meowthink/thermocouple/hardware/DAS.kicad_pcb

## KiCad design hardware/DAS.kicad_pcb (2016-05-21)

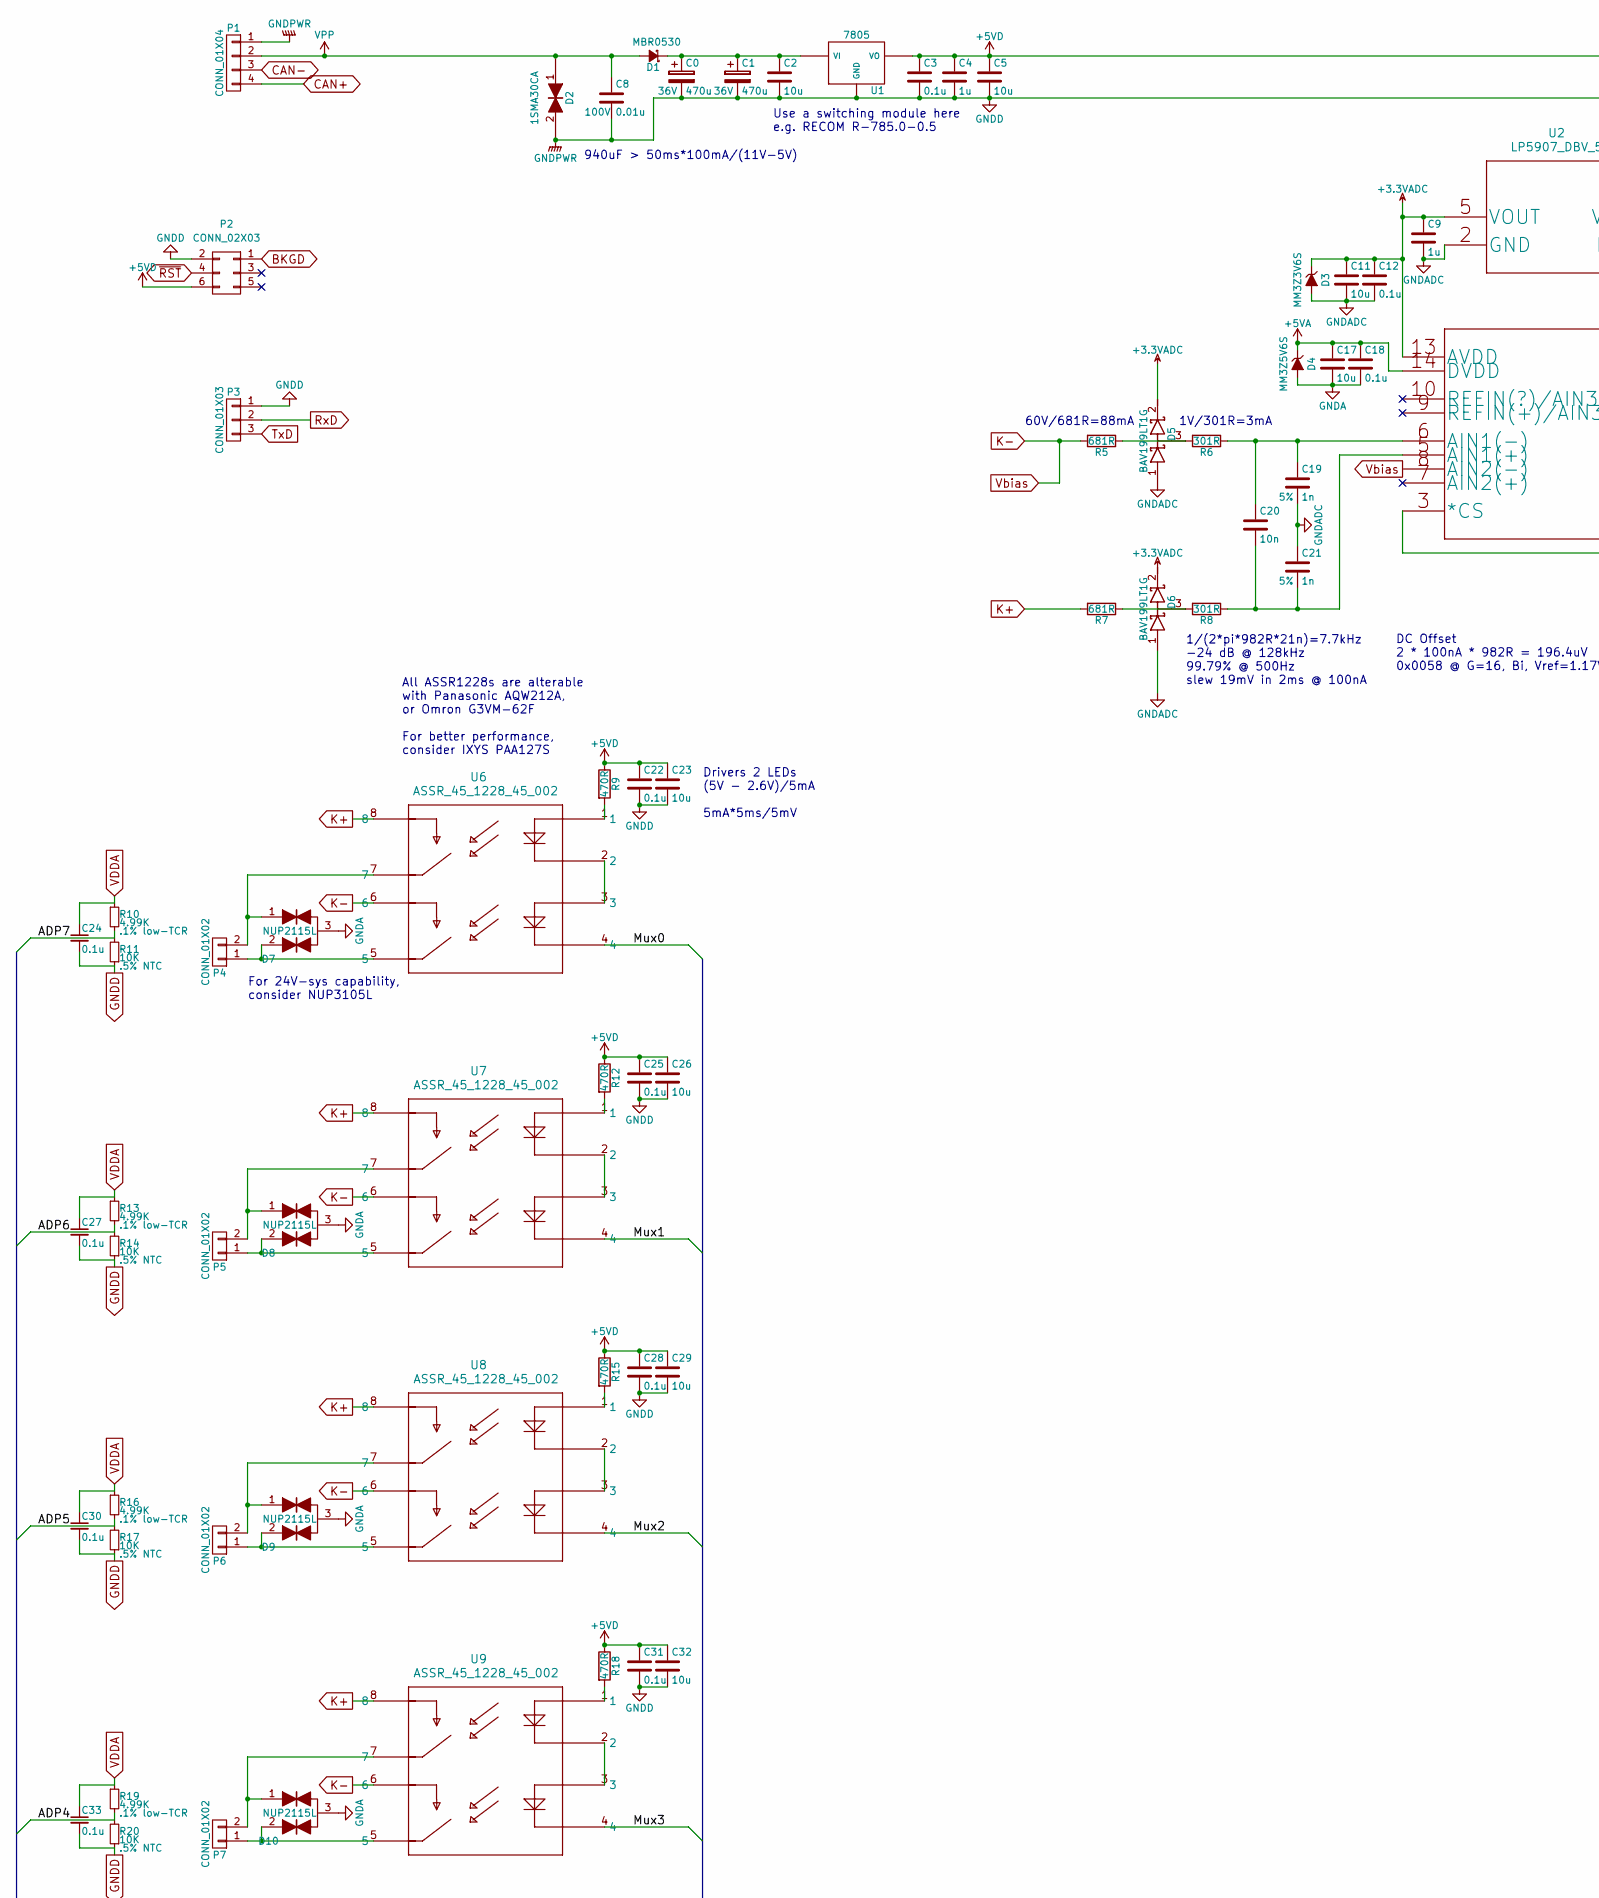
[picture p1: schematic DAS.sch, part in row 1, column 1]

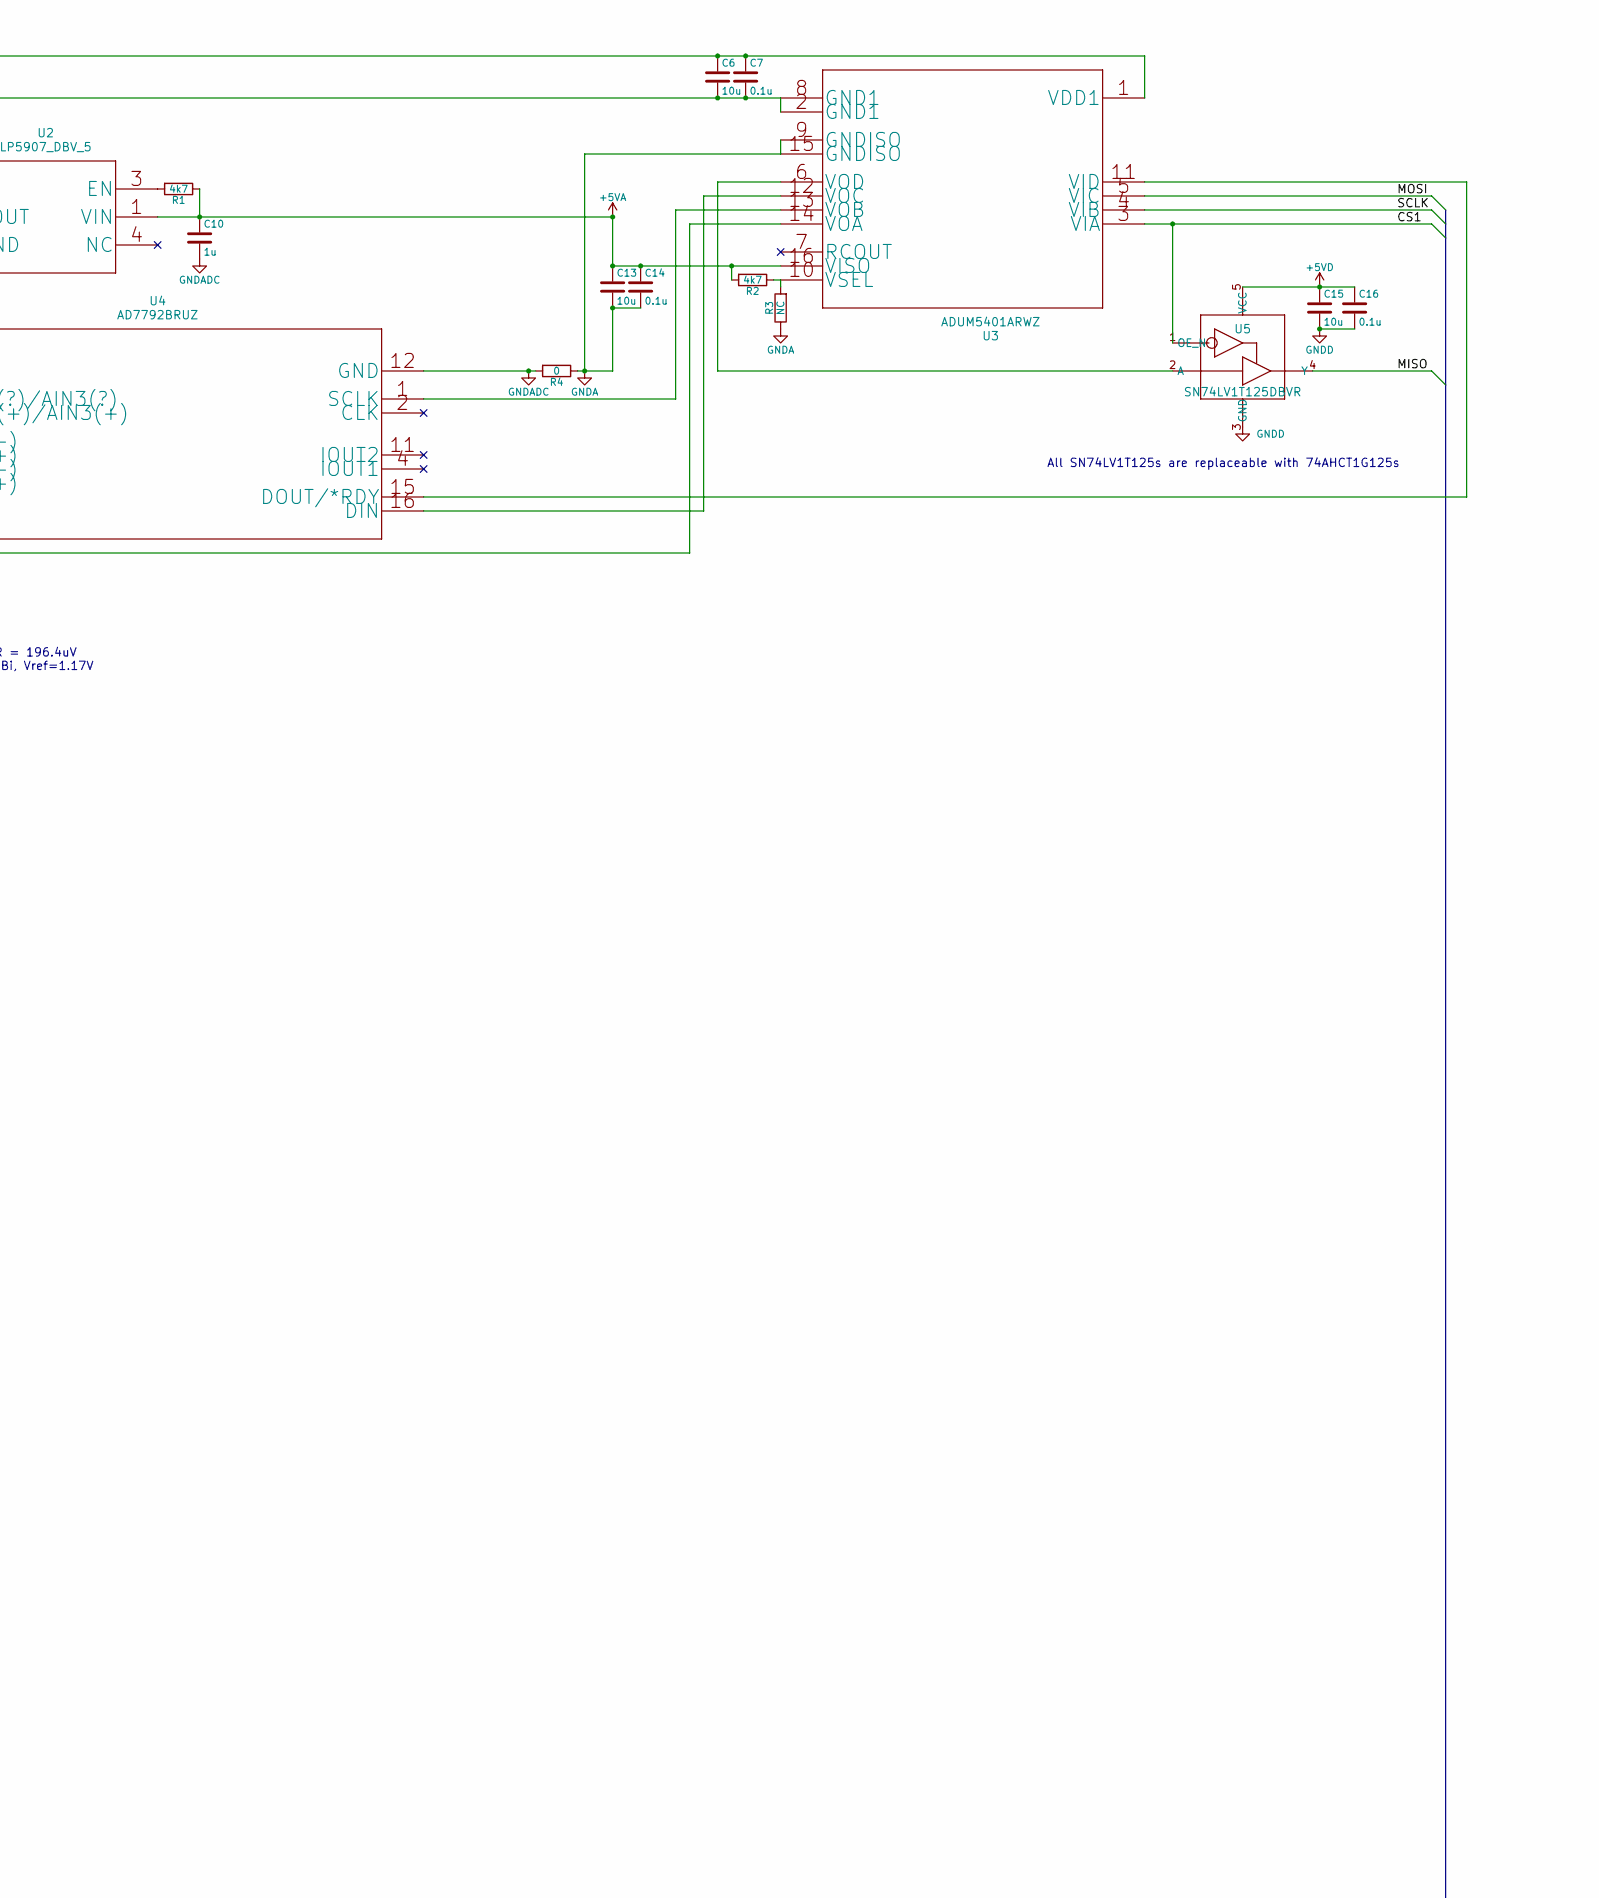
[picture p2: schematic DAS.sch, part in row 1, column 2]

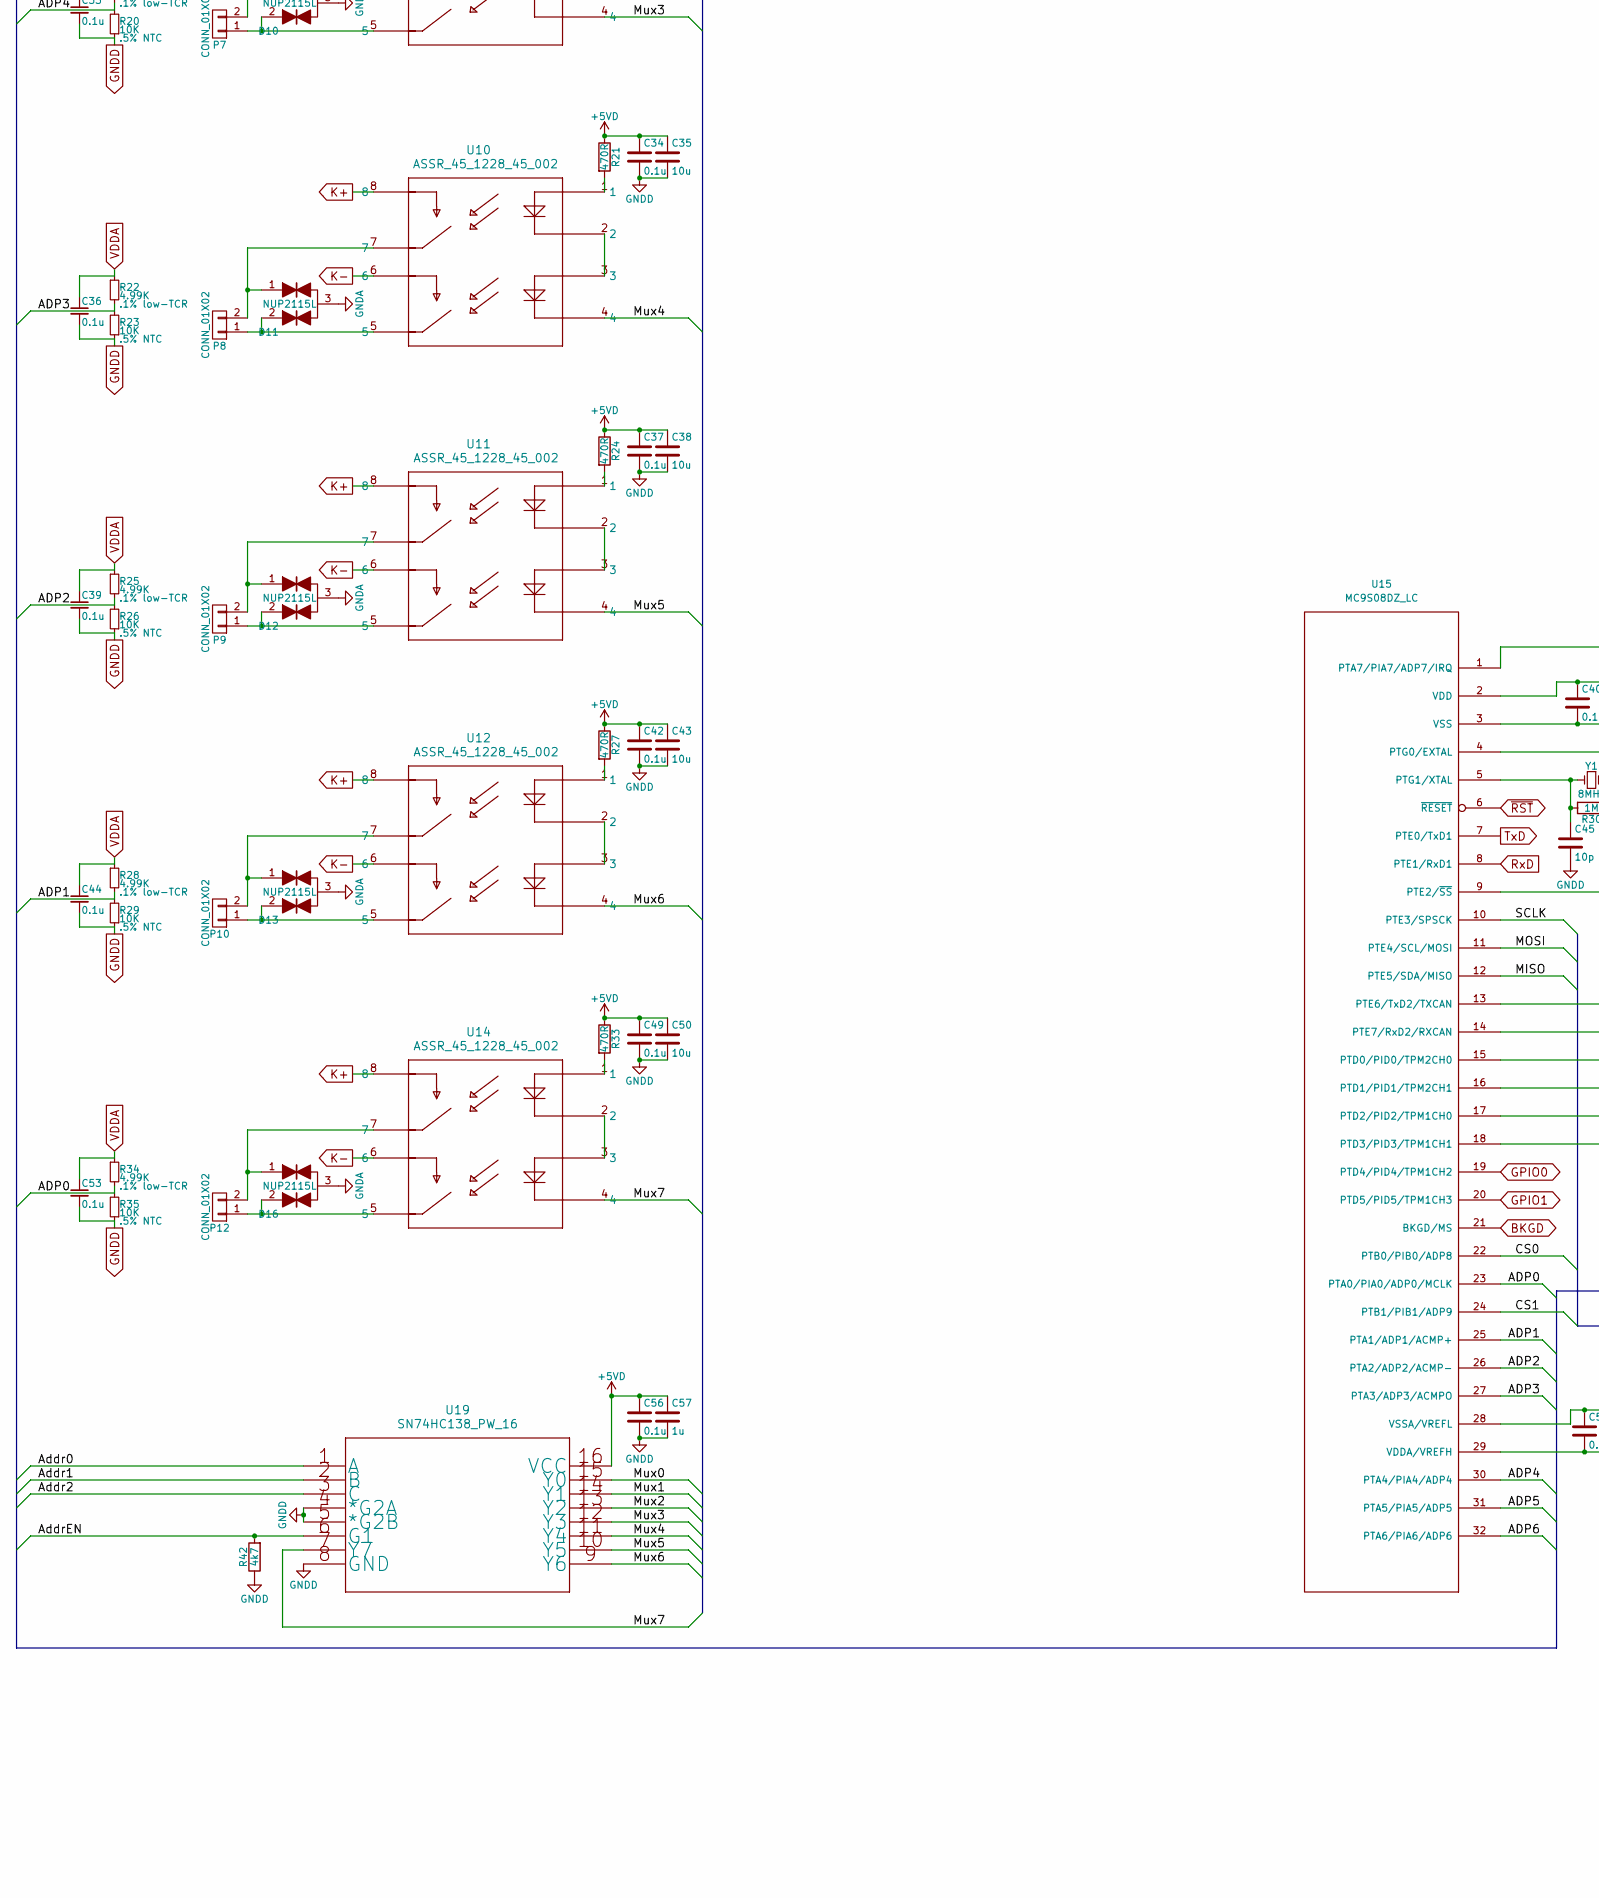
[picture p3: schematic DAS.sch, part in row 2, column 1]

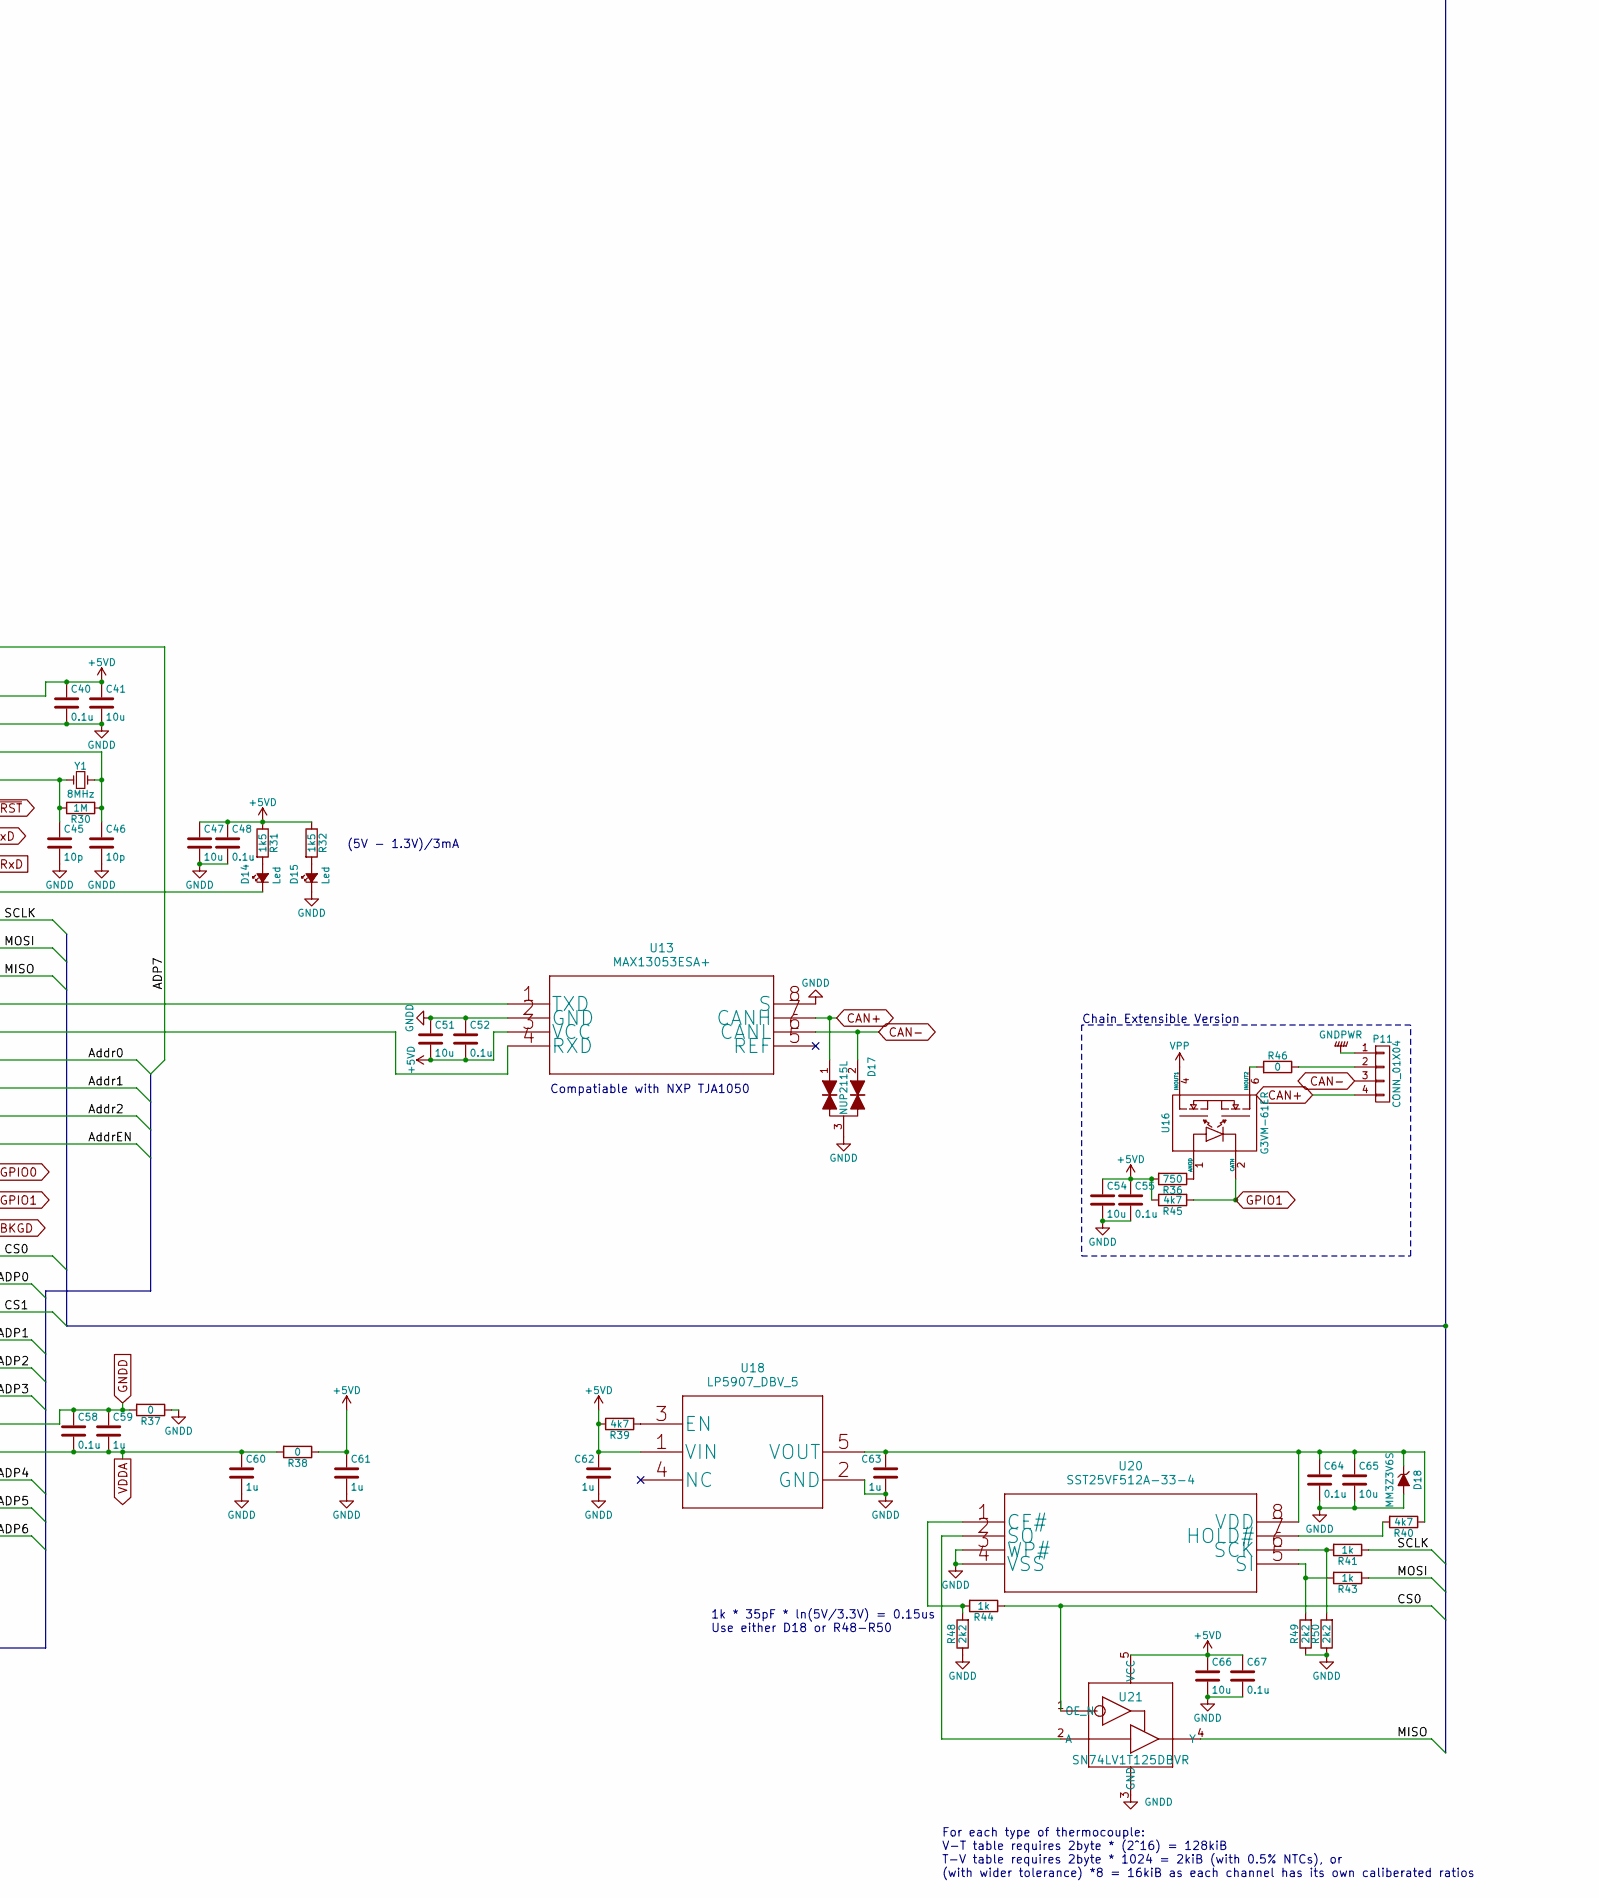
[picture p4: schematic DAS.sch, part in row 2, column 2]

Parts:
C0, C1: 470u; c_elec_10x10.5
C2, C5, C6, C11, C13, C15, C17, C23, C26, C29, C32, C35, C38, C41, C43, C47, C50, C51, C54, C65, C66: 10u; C_0805
C3, C7, C12, C14, C16, C18, C22, C24, C25, C27, C28, C30, C31, C33, C34, C36, C37, C39, C40, C42, C44, C48, C49, C52, C53, C55, C56, C58, C64, C67: 0.1u; C_0805
C4, C9, C10, C57, C59, C60, C61, C62, C63: 1u; C_0805
C8: 0.01u; C_0805
C19, C21: 1n; C_0805
C20: 10n; C_0805
C45, C46: 10p; C_0805
D1: MBR0530; SOD-123
D2: 1SMA30CA; SMA_Standard
D3, D18: MM3Z3V6S; SOD-323
D4: MM3Z5V6S; SOD-323
D5, D6: BAV199LT1G; SOT-23
D7, D8, D9, D10, D11, D12, D13, D16, D17: NUP2115L; SOT-23
D14, D15: Led; LED-5MM
P1, P11: CONN_01X04; Pin_Header_Straight_1x04
P2: CONN_02X03; Pin_Header_Straight_2x03
P3: CONN_01X03; Pin_Header_Straight_1x03
P4, P5, P6, P7, P8, P9, P10, P12: CONN_01X02; Thermocouple
R1, R2, R39, R40, R42, R45: 4k7; R_0805
R3: NC; R_0805
R4, R37, R38, R46: 0; R_0805
R5, R7: 681R; R_0805
R6, R8: 301R; R_0805
R9, R12, R15, R18, R21, R24, R27, R33: 470R; R_0805
R10, R13, R16, R19, R22, R25, R28, R34: 4.99K; R_0805
R11, R14, R17, R20, R23, R26, R29, R35: 10K; Thermoresistor
R30: 1M; R_0805
R31, R32: 1k5; R_0805
R36: 750; R_0805
R41, R43, R44: 1k; R_0805
R48, R49, R50: 2k2; R_0805
U1: 7805; DCDC-Conv_Recom_R-78HBxx-0.5
U2, U18: LP5907_DBV_5
U3: ADUM5401ARWZ; ADUM5401WCRWZ
U4: AD7792BRUZ
U5, U21: SN74LV1T125DBVR
U6, U7, U8, U9, U10, U11, U12, U14: ASSR_45_1228_45_002; SMD-8
U13: MAX13053ESA+
U15: MC9S08DZ_LC; LQFP-32_7x7mm_Pitch0.8mm
U16: G3VM-61ER; SMD-6
U19: SN74HC138_PW_16
U20: SST25VF512A-33-4
Y1: 8MHz; Crystal_HC49-SD_SMD

Connections:
+3.3VADC: C9.1, C11.1, C12.1, D3.1 (K), D5.2 (K), D6.2 (K), U2.5 (VOUT), U4.13 (AVDD)
+5VA: C10.1, C13.1, C14.1, C17.1, C18.1, D4.1 (K), R1.1, R2.2, U2.1 (VIN), U3.16 (VISO), U4.14 (DVDD)
+5VD: C3.1, C4.1, C5.1, C6.1, C7.1, C15.1, C16.1, C22.1, C23.1, C25.1, C26.1, C28.1, C29.1, C31.1, C32.1, C34.1, C35.1, C37.1, C38.1, C40.1, C41.1, C42.1, C43.1, C47.1, C48.1, C49.1, C50.1, C51.2, C52.2, C54.1, C55.1, C56.1, C57.1, C61.1, C62.1, C66.1, C67.1, P2.6, R9.1, R12.1, R15.1, R18.1, R21.1, R24.1, R27.1, R31.1, R32.1, R33.1, R36.2, R38.1, R39.1, R45.1, U1.1 (VO), U3.1 (VDD1), U5.5 (VCC), U13.3 (VCC), U15.2 (VDD), U18.1 (VIN), U19.16 (VCC), U21.5 (VCC)
/ADP0: R34.2, R35.2, U15.23 (PTA0/PIA0/ADP0/MCLK)
/ADP1: R28.2, R29.2, U15.25 (PTA1/ADP1/ACMP+)
/ADP2: R25.2, R26.2, U15.26 (PTA2/ADP2/ACMP-)
/ADP3: R22.2, R23.2, U15.27 (PTA3/ADP3/ACMPO)
/ADP4: R19.2, R20.2, U15.30 (PTA4/PIA4/ADP4)
/ADP5: R16.2, R17.2, U15.31 (PTA5/PIA5/ADP5)
/ADP6: R13.2, R14.2, U15.32 (PTA6/PIA6/ADP6)
/ADP7: R10.2, R11.2, U15.1 (PTA7/PIA7/ADP7/IRQ)
/Addr0: U15.15 (PTD0/PID0/TPM2CH0), U19.1 (A)
/Addr1: U15.16 (PTD1/PID1/TPM2CH1), U19.2 (B)
/Addr2: U15.17 (PTD2/PID2/TPM1CH0), U19.3 (C)
/AddrEN: R42.2, U15.18 (PTD3/PID3/TPM1CH1), U19.6 (G1)
/CS0: R44.1, U15.22 (PTB0/PIB0/ADP8), U21.1 (OE_N)
/CS1: U3.3 (VIA), U5.1 (OE_N), U15.24 (PTB1/PIB1/ADP9)
/MISO: U5.4 (Y), U15.12 (PTE5/SDA/MISO), U21.4 (Y)
/MOSI: R43.1, U3.5 (VIC), U15.11 (PTE4/SCL/MOSI)
/Mux0: U6.4, U19.15 (Y0)
/Mux1: U7.4, U19.14 (Y1)
/Mux2: U8.4, U19.13 (Y2)
/Mux3: U9.4, U19.12 (Y3)
/Mux4: U10.4, U19.11 (Y4)
/Mux5: U11.4, U19.10 (Y5)
/Mux6: U12.4, U19.9 (Y6)
/Mux7: U14.4, U19.7 (Y7)
/SCLK: R41.1, U3.4 (VIB), U15.10 (PTE3/SPSCK)
BKGD: P2.1, U15.21 (BKGD/MS)
CAN+: D17.1, P1.4, P11.4, U13.7 (CANH)
CAN-: D17.2, P1.3, P11.3, U13.6 (CANL)
GNDA: C13.2, C14.2, C17.2, C18.2, D4.2 (A), D7.3, D8.3, D9.3, D10.3, D11.3, D12.3, D13.3, D16.3, R3.1, R4.1, U3.9 (GNDISO), U3.15 (GNDISO)
GNDADC: C9.2, C10.2, C11.2, C12.2, C19.2, C21.1, D3.2 (A), D5.1 (A), D6.1 (A), R4.2, U2.2 (GND), U4.12 (GND)
GNDD: C0.2, C1.2, C2.2, C3.2, C4.2, C5.2, C6.2, C7.2, C8.2, C15.2, C16.2, C22.2, C23.2, C24.2, C25.2, C26.2, C27.2, C28.2, C29.2, C30.2, C31.2, C32.2, C33.2, C34.2, C35.2, C36.2, C37.2, C38.2, C39.2, C40.2, C41.2, C42.2, C43.2, C44.2, C45.2, C46.2, C47.2, C48.2, C49.2, C50.2, C51.1, C52.1, C53.2, C54.2, C55.2, C56.2, C57.2, C58.1, C59.1, C60.2, C61.2, C62.2, C63.2, C64.2, C65.2, C66.2, C67.2, D2.2, D15.1 (K), D17.3, D18.2 (A), P1.1, P2.2, P3.1, P11.1, R11.1, R14.1, R17.1, R20.1, R23.1, R26.1, R29.1, R35.1, R37.1, R37.2, R42.1, R48.1, R49.1, R50.1, U1.2 (GND), U3.2 (GND1), U3.8 (GND1), U5.3 (GND), U13.2 (GND), U13.8 (S), U15.3 (VSS), U15.28 (VSSA/VREFL), U18.2 (GND), U19.4 (*G2A), U19.5 (*G2B), U19.8 (GND), U20.3 (WP#), U20.4 (VSS), U21.3 (GND)
GPIO0: U15.19 (PTD4/PID4/TPM1CH2)
GPIO1: R45.2, U15.20 (PTD5/PID5/TPM1CH3), U16.2 (CATH)
K+: R7.2, U6.8, U7.8, U8.8, U9.8, U10.8, U11.8, U12.8, U14.8
K-: R5.2, U4.8 (AIN2(-)), U6.6, U7.6, U8.6, U9.6, U10.6, U11.6, U12.6, U14.6
unnamed: C0.1, C1.1, C2.1, D1.1 (K), U1.3 (VI)
unnamed: C19.1, C20.1, R6.1, U4.6 (AIN1(-))
unnamed: C20.2, C21.2, R8.1, U4.5 (AIN1(+))
unnamed: C45.1, R30.1, U15.5 (PTG1/XTAL), Y1.1
unnamed: C46.1, R30.2, U15.4 (PTG0/EXTAL), Y1.2
unnamed: C63.1, C64.1, C65.1, D18.1 (K), R40.1, U18.5 (VOUT), U20.8 (VDD)
unnamed: D5.3 (common), R5.1, R6.2
unnamed: D6.3 (common), R7.1, R8.2
unnamed: D7.1, P4.2, U6.7
unnamed: D7.2, P4.1, U6.5
unnamed: D8.1, P5.2, U7.7
unnamed: D8.2, P5.1, U7.5
unnamed: D9.1, P6.2, U8.7
unnamed: D9.2, P6.1, U8.5
unnamed: D10.1, P7.2, U9.7
unnamed: D10.2, P7.1, U9.5
unnamed: D11.1, P8.2, U10.7
unnamed: D11.2, P8.1, U10.5
unnamed: D12.1, P9.2, U11.7
unnamed: D12.2, P9.1, U11.5
unnamed: D13.1, P10.2, U12.7
unnamed: D13.2, P10.1, U12.5
unnamed: D14.1 (K), U15.9 (PTE2/~SS)
unnamed: D14.2 (A), R31.2
unnamed: D15.2 (A), R32.2
unnamed: D16.1, P12.2, U14.7
unnamed: D16.2, P12.1, U14.5
unnamed: P11.2, R46.1
unnamed: R1.2, U2.3 (EN)
unnamed: R2.1, R3.2, U3.10 (VSEL)
unnamed: R9.2, U6.1
unnamed: R12.2, U7.1
unnamed: R15.2, U8.1
unnamed: R18.2, U9.1
unnamed: R21.2, U10.1
unnamed: R24.2, U11.1
unnamed: R27.2, U12.1
unnamed: R33.2, U14.1
unnamed: R36.1, U16.1 (ANOD)
unnamed: R39.2, U18.3 (EN)
unnamed: R40.2, U20.7 (HOLD#)
unnamed: R41.2, R50.2, U20.6 (SCK)
unnamed: R43.2, R49.2, U20.5 (SI)
unnamed: R44.2, R48.2, U20.1 (CE#)
unnamed: R46.2, U16.6 (INOUT2)
unnamed: U3.6 (VOD), U5.2 (A)
unnamed: U3.11 (VID), U4.15 (DOUT/*RDY)
unnamed: U3.12 (VOC), U4.16 (DIN)
unnamed: U3.13 (VOB), U4.1 (SCLK)
unnamed: U3.14 (VOA), U4.3 (*CS)
unnamed: U6.2, U6.3
unnamed: U7.2, U7.3
unnamed: U8.2, U8.3
unnamed: U9.2, U9.3
unnamed: U10.2, U10.3
unnamed: U11.2, U11.3
unnamed: U12.2, U12.3
unnamed: U13.1 (TXD), U15.13 (PTE6/TxD2/TXCAN)
unnamed: U13.4 (RXD), U15.14 (PTE7/RxD2/RXCAN)
unnamed: U14.2, U14.3
unnamed: U20.2 (SO), U21.2 (A)
RxD: P3.2, U15.8 (PTE1/RxD1)
TxD: P3.3, U15.7 (PTE0/TxD1)
VDDA: C24.1, C27.1, C30.1, C33.1, C36.1, C39.1, C44.1, C53.1, C58.2, C59.2, C60.1, R10.1, R13.1, R16.1, R19.1, R22.1, R25.1, R28.1, R34.1, R38.2, U15.29 (VDDA/VREFH)
VPP: C8.1, D1.2 (A), D2.1, P1.2, U16.4 (INOUT1)
~RST: P2.4, U15.6 (~RESET)

Notes on the sheet:
Use a switching module here e.g. RECOM R-785.0-0.5
Drivers 2 LEDs (5V - 2.6V)/5mA 5mA*5ms/5mV
1V/301R=3mA
60V/681R=88mA
1/(2*pi*982R*21n)=7.7kHz -24 dB @ 128kHz 99.79% @ 500Hz slew 19mV in 2ms @ 100nA
All ASSR1228s are alterable with Panasonic AQW212A, or Omron G3VM-62F For better performance, consider IXYS PAA127S
DC Offset 2 * 100nA * 982R = 196.4uV 0x0058 @ G=16, Bi, Vref=1.17V
For 24V-sys capability, consider NUP3105L
All SN74LV1T125s are replaceable with 74AHCT1G125s
940uF > 50ms*100mA/(11V-5V)
Compatiable with NXP TJA1050
(5V - 1.3V)/3mA
Chain Extensible Version
For each type of thermocouple: V-T table requires 2byte * (2^16) = 128kiB T-V table requires 2byte * 1024 = 2kiB (with 0.5% NTCs), or (with wider tolerance) *8 = 16kiB as each channel has its own caliberated ratios
1k * 35pF * ln(5V/3.3V) = 0.15us Use either D18 or R48-R50

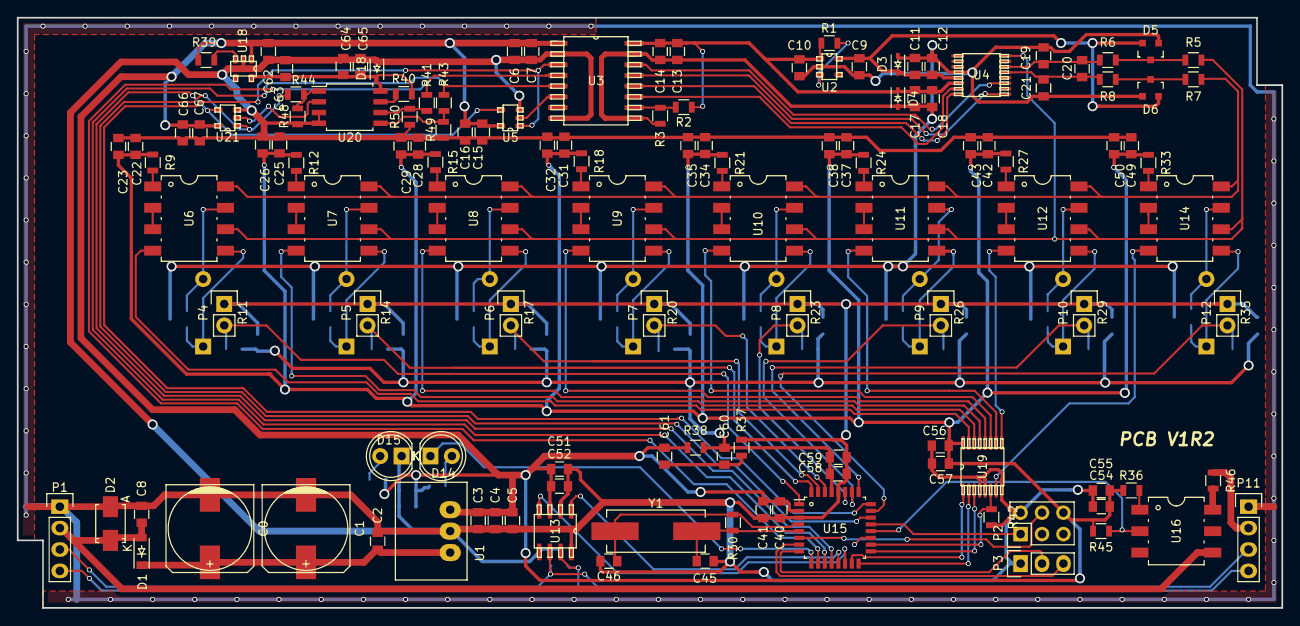
[picture p5: board DAS.kicad_pcb from above]

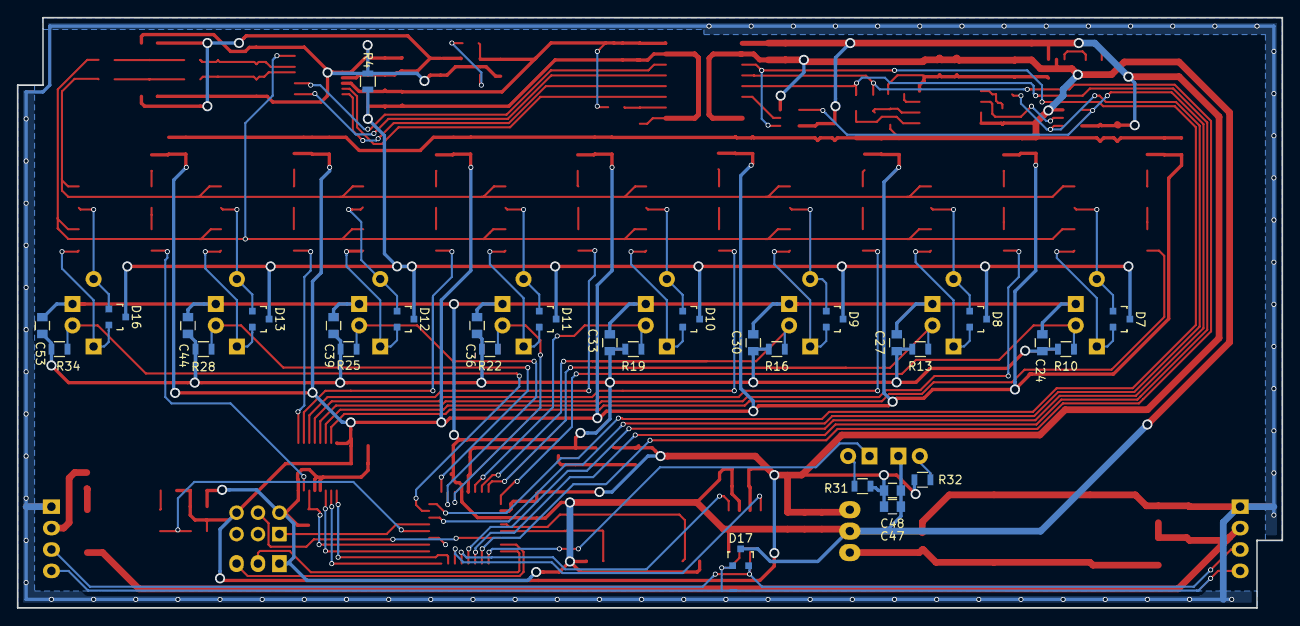
[picture p6: board DAS.kicad_pcb from below]

Board: 2 copper layers, 150.0 x 70.0 mm, 168 parts (30 on the bottom side), 103 nets.
