meowthink/thermocouple/(commit log)

2016-05-20 Initial commit. A prototype has been made and tested to be functional.
    [DAS-B.Cu.gbl, DAS-B.Mask.gbs, DAS-B.SilkS.gbo, DAS-Edge.Cuts.gm1, DAS-F.Cu.gtl, DAS-F.Mask.gts, DAS-F.SilkS.gto, DAS-drl_map.gbr]
2016-05-21 Try fix issues found out during prototyping. Misused LDO supplying VDDA removed. Wrong pin assignment to DC-DC module corrected. Footprint of SPI Flash tweaked to allow wider selection of parts. A pu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
    [DAS-B.Cu.gbl, DAS-B.Mask.gbs, DAS-B.SilkS.gbo, DAS-Edge.Cuts.gm1, DAS-F.Cu.gtl, DAS-F.Mask.gts, DAS-F.SilkS.gto, DAS-drl_map.gbr]
2016-05-23 Prototype Firmware: Try to achieve higher precision on Cold-Junction compensation
    [serial_writer.xlsm]
2016-06-04 Prototype Firmware: Try fix misusing of CAN tx slots
